LucasStrand/open-duck-mini-duckling/images/duckling-preview.png

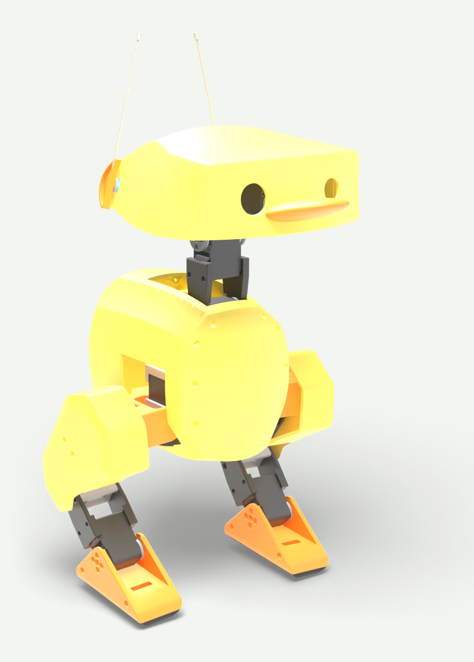
images/duckling-preview.png
