LucasStrand/open-duck-mini-duckling/stl/addons/duck_tail.stl

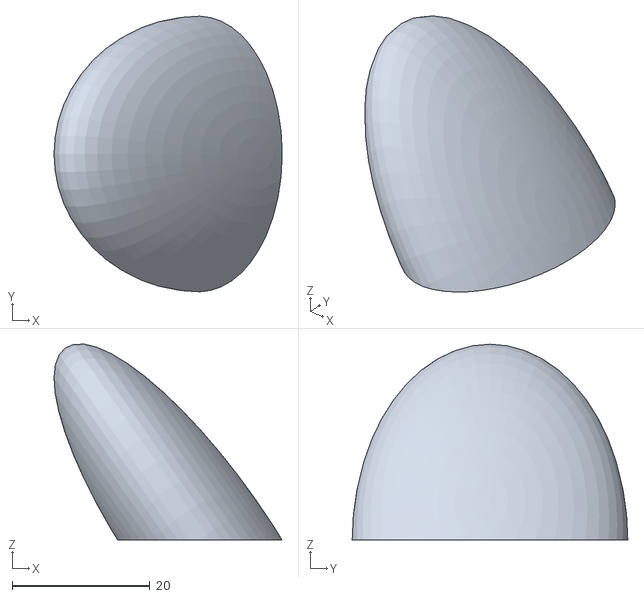
[picture p7: CAD file, 2026-10-24]
stl/addons/duck_tail.stl
33.1 x 40.0 x 28.4
