LucasStrand/open-duck-mini-duckling/stl/duckling/body_middle_top_duckling.stl

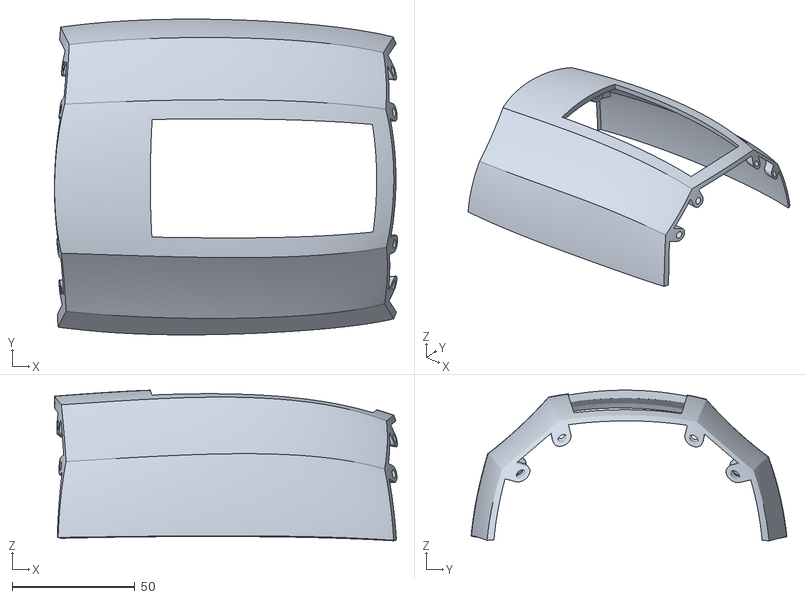
[picture p8: CAD file, 2026-10-24]
stl/duckling/body_middle_top_duckling.stl
139.8 x 128.7 x 61.4
