LucasStrand/open-duck-mini-duckling/stl/original/roll_motor_bottom.stl

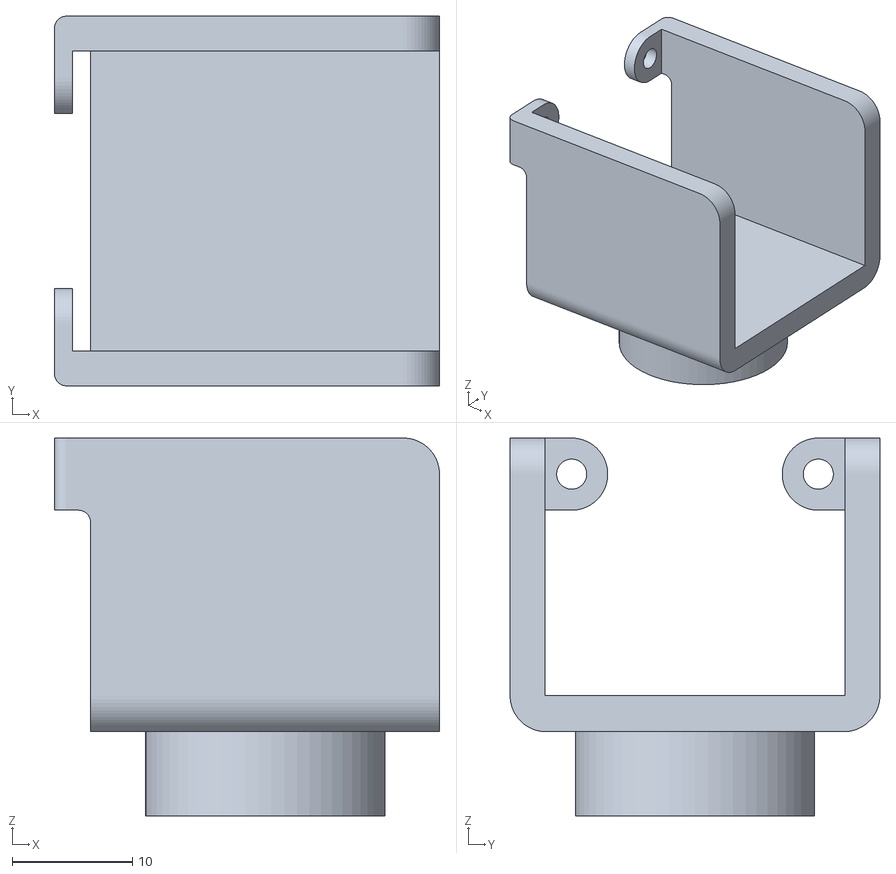
[picture p9: CAD file, 2026-10-24]
stl/original/roll_motor_bottom.stl
32.0 x 30.7 x 31.4
