LucasStrand/open-duck-mini-duckling/stl/pebble/body_front_pebble.stl

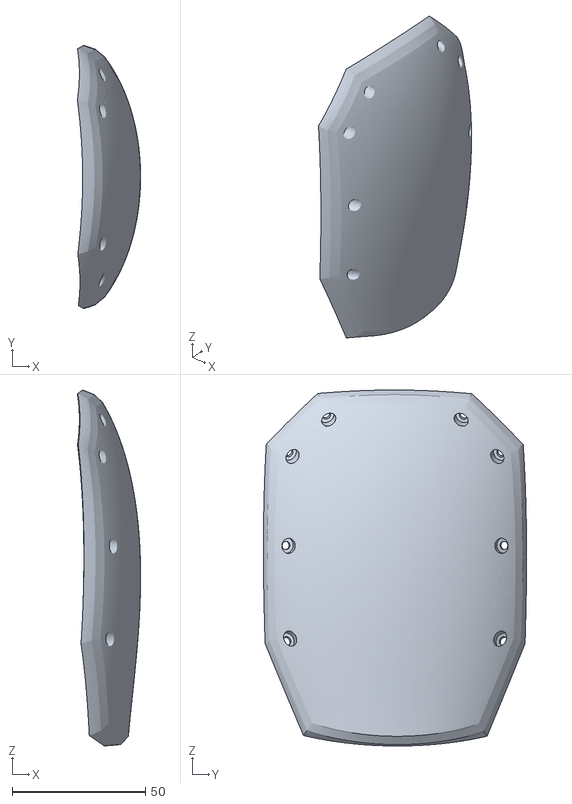
[picture p10: CAD file, 2026-10-24]
stl/pebble/body_front_pebble.stl
23.7 x 98.8 x 133.7
