LucasStrand/open-duck-mini-duckling/stl/visor/head_bot_sheet_visor.stl

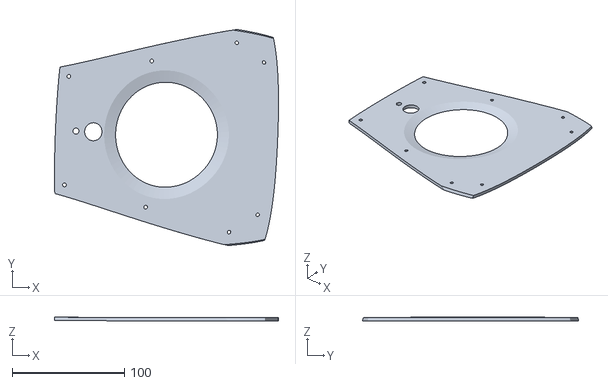
[picture p11: CAD file, 2026-10-24]
stl/visor/head_bot_sheet_visor.stl
199.8 x 192.8 x 3.16
