LucasStrand/open-duck-mini-duckling/stl/addons/duck_bill.stl

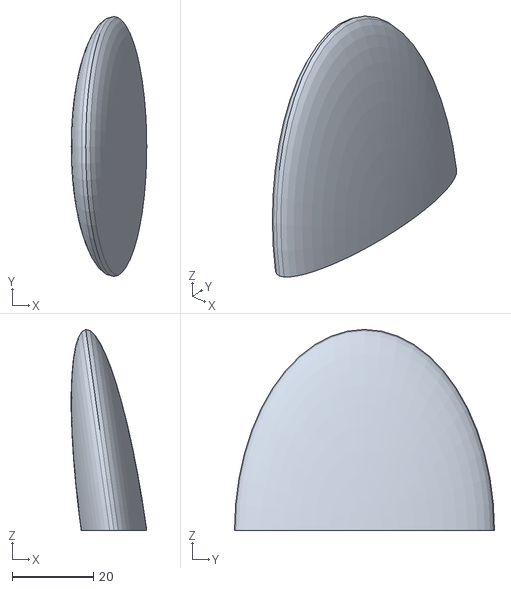
[picture p12: CAD file, 2026-10-24]
stl/addons/duck_bill.stl
18.6 x 64.0 x 49.5
