LucasStrand/open-duck-mini-duckling/stl/duckling/body_back_duckling.stl

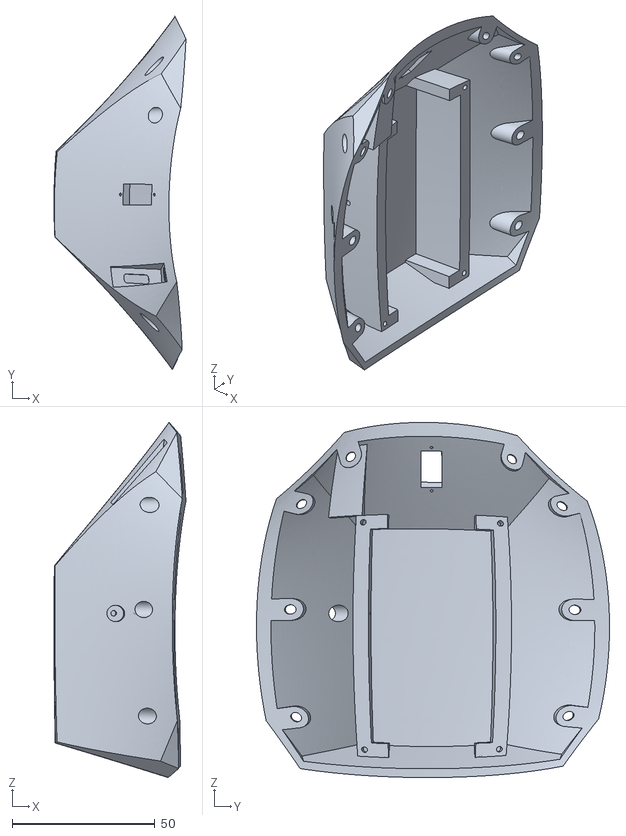
[picture p13: CAD file, 2026-10-24]
stl/duckling/body_back_duckling.stl
46.2 x 123.6 x 124.3
