LucasStrand/open-duck-mini-duckling/stl/original/right_eye.stl

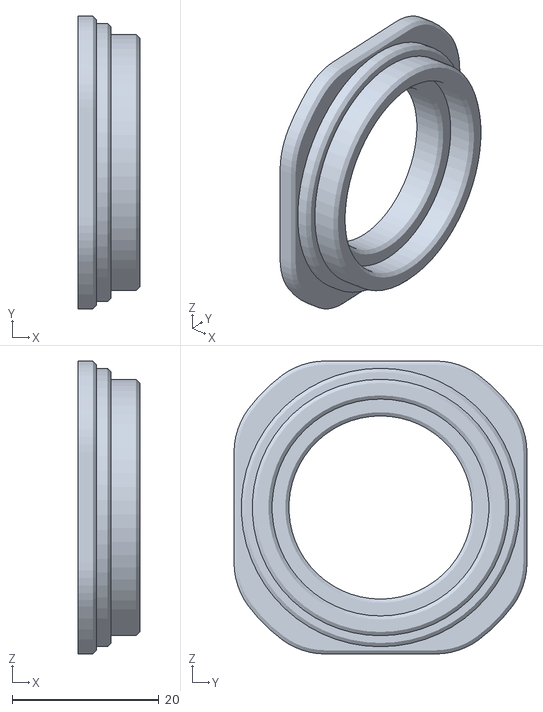
[picture p14: CAD file, 2026-10-24]
stl/original/right_eye.stl
8.40 x 40.0 x 40.0
