LucasStrand/open-duck-mini-duckling/stl/pebble/left_antenna_holder_pebble.stl

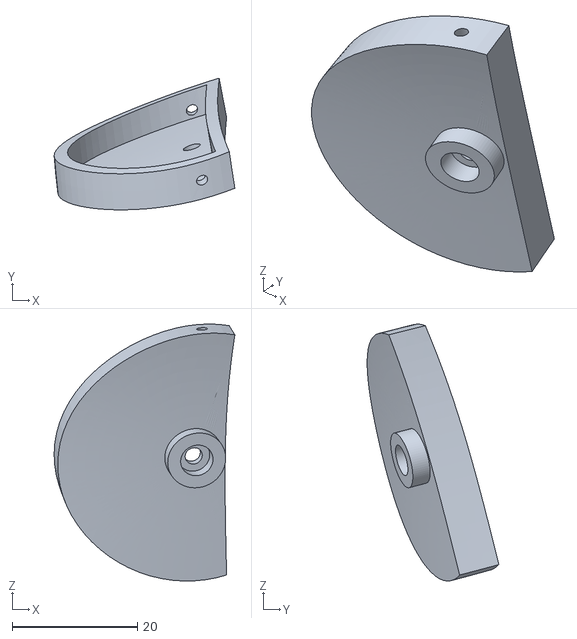
[picture p15: CAD file, 2026-10-24]
stl/pebble/left_antenna_holder_pebble.stl
28.9 x 21.0 x 41.1
