LucasStrand/open-duck-mini-duckling/stl/visor/right_cache_visor.stl

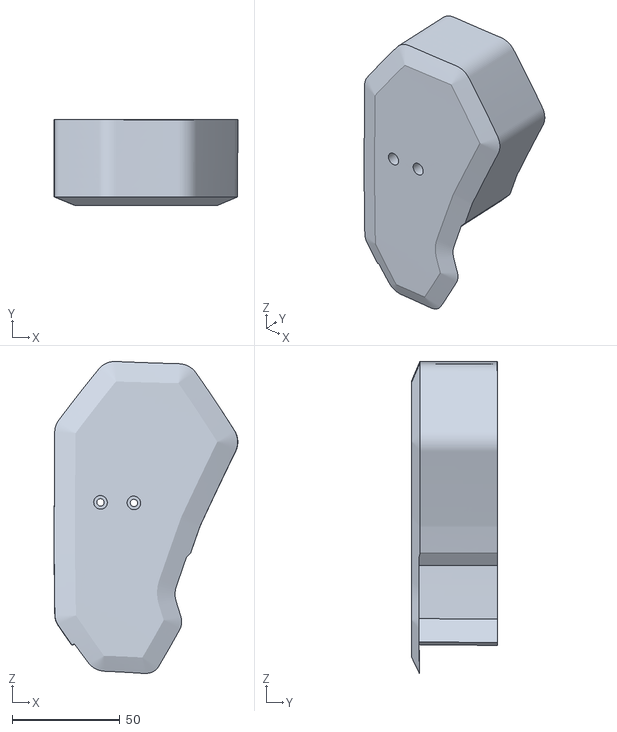
[picture p16: CAD file, 2026-10-24]
stl/visor/right_cache_visor.stl
85.4 x 40.2 x 145.0
