LucasStrand/open-duck-mini-duckling/stl/duckling/head_duckling.stl

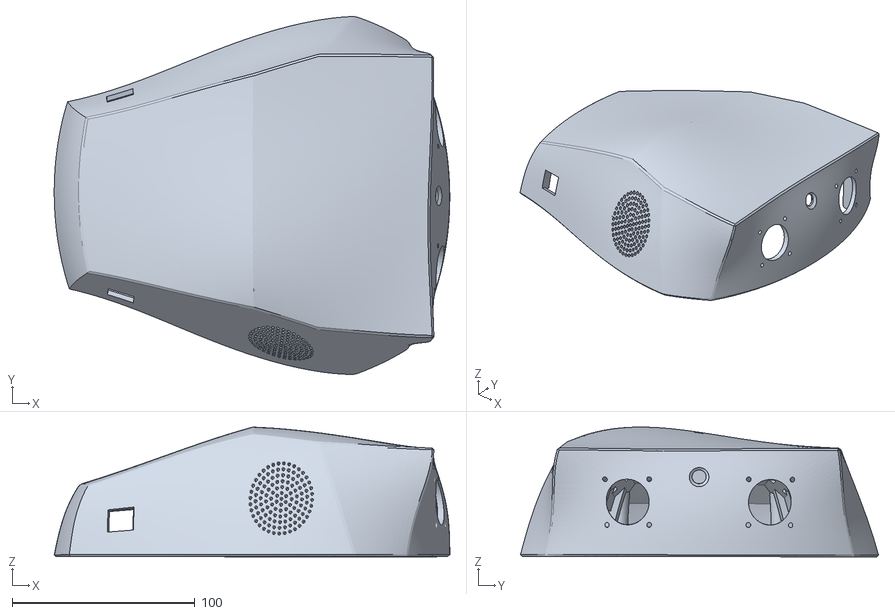
[picture p17: CAD file, 2026-10-24]
stl/duckling/head_duckling.stl
216.3 x 195.8 x 71.0
