LucasStrand/open-duck-mini-duckling/stl/original/left_roll_to_pitch.stl

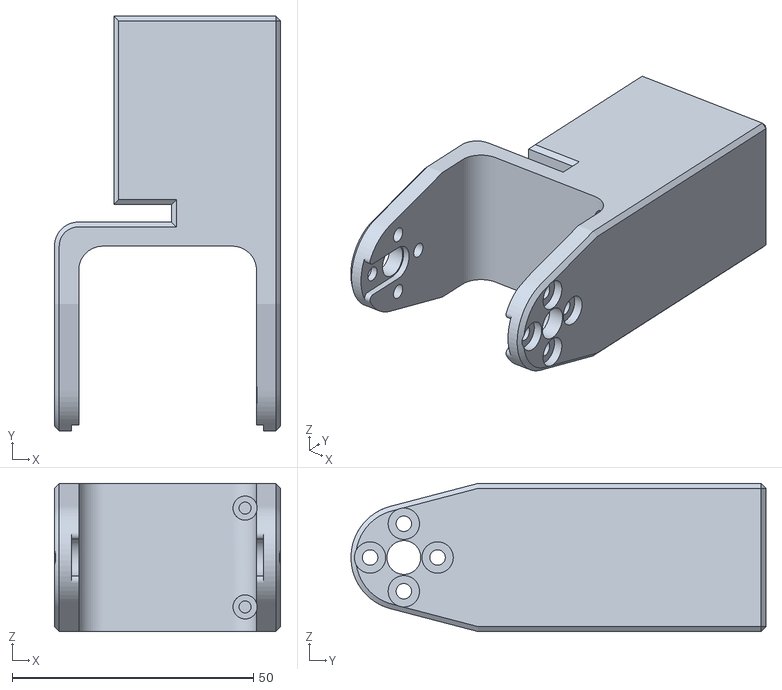
[picture p18: CAD file, 2026-10-24]
stl/original/left_roll_to_pitch.stl
46.9 x 86.1 x 30.7
