LucasStrand/open-duck-mini-duckling/stl/pebble/head_bot_sheet_pebble.stl

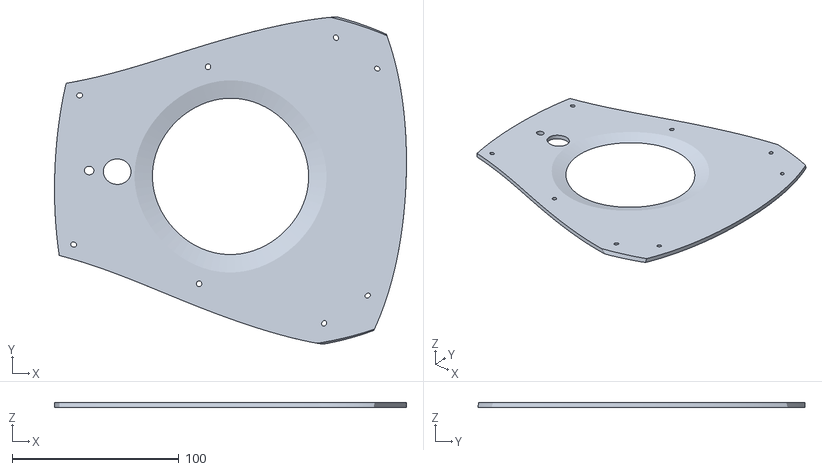
[picture p19: CAD file, 2026-10-24]
stl/pebble/head_bot_sheet_pebble.stl
210.8 x 196.1 x 3.02
