LucasStrand/open-duck-mini-duckling/stl/duckling/right_antenna_holder_duckling.stl

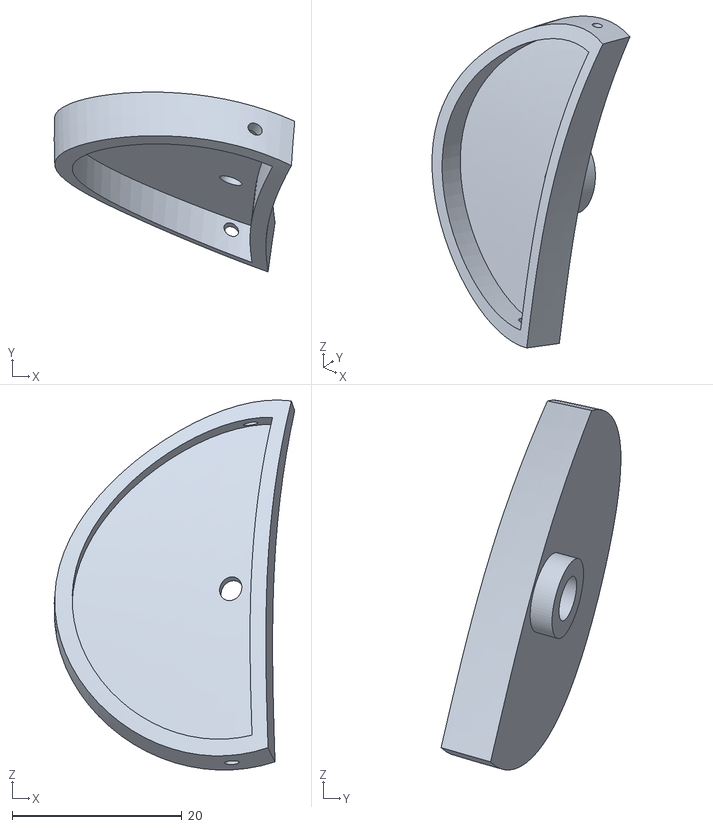
[picture p20: CAD file, 2026-10-24]
stl/duckling/right_antenna_holder_duckling.stl
28.3 x 21.2 x 43.6
