LucasStrand/open-duck-mini-duckling/stl/original/bulb.stl

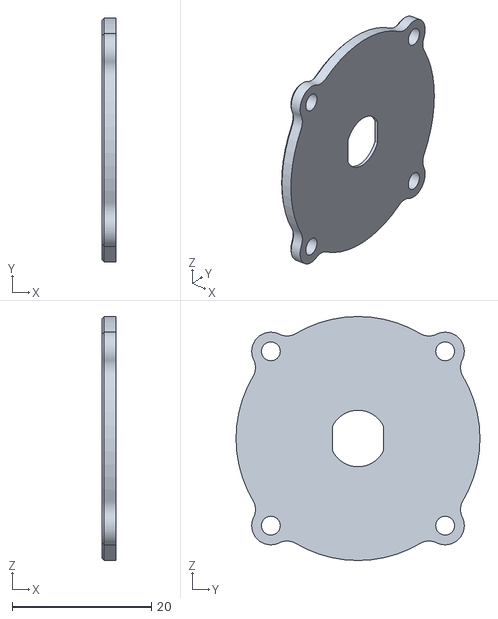
[picture p21: CAD file, 2026-10-24]
stl/original/bulb.stl
2.00 x 35.0 x 35.0
