LucasStrand/open-duck-mini-duckling/stl/pebble/body_middle_top_pebble.stl

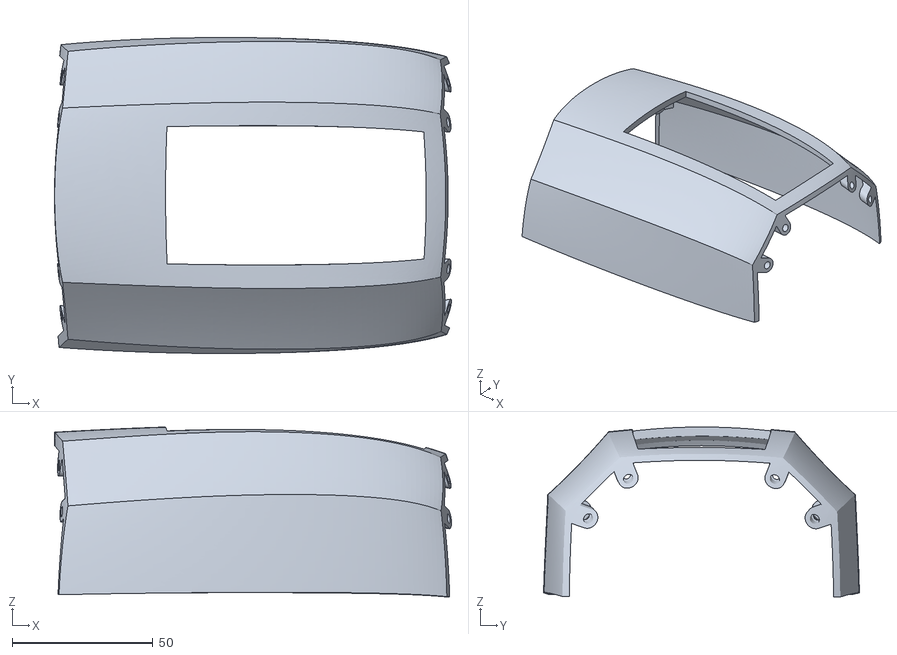
[picture p22: CAD file, 2026-10-24]
stl/pebble/body_middle_top_pebble.stl
141.0 x 112.2 x 60.4
