LucasStrand/open-duck-mini-duckling/stl/visor/body_back_visor.stl

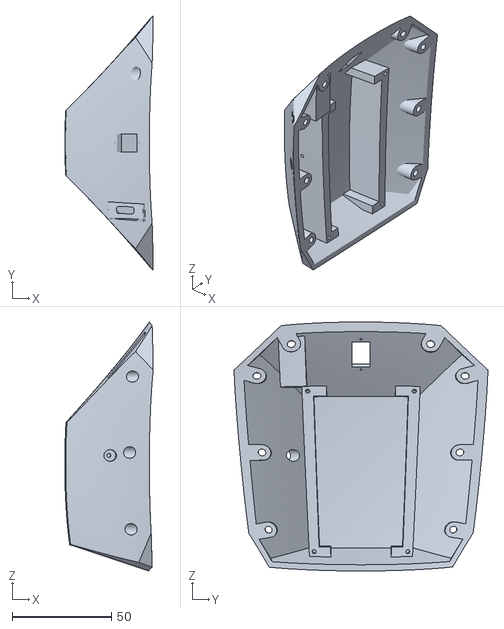
[picture p23: CAD file, 2026-10-24]
stl/visor/body_back_visor.stl
44.5 x 127.9 x 125.4
