LucasStrand/open-duck-mini-duckling/stl/duckling/battery_pack_lid_duckling.stl

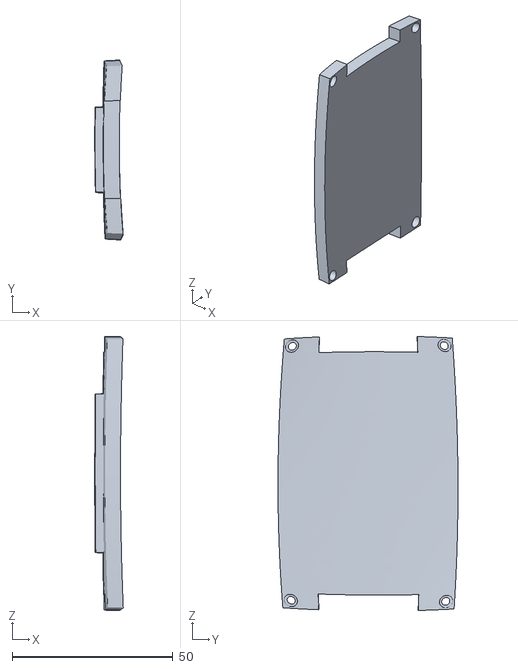
[picture p24: CAD file, 2026-10-24]
stl/duckling/battery_pack_lid_duckling.stl
8.90 x 56.0 x 85.3
