LucasStrand/open-duck-mini-duckling/stl/original/head_roll_mount.stl

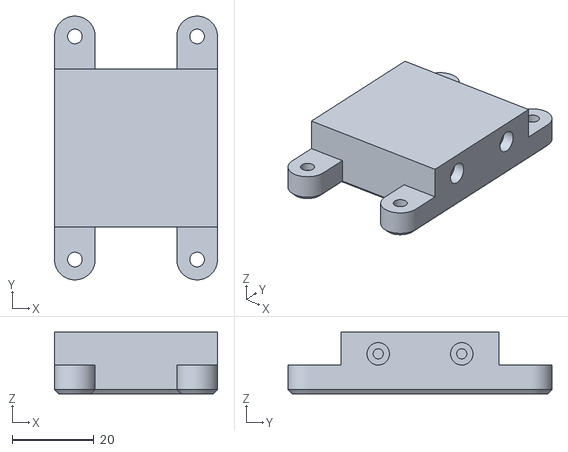
[picture p25: CAD file, 2026-10-24]
stl/original/head_roll_mount.stl
40.0 x 64.7 x 15.1
