LucasStrand/open-duck-mini-duckling/stl/pebble/body_back_pebble.stl

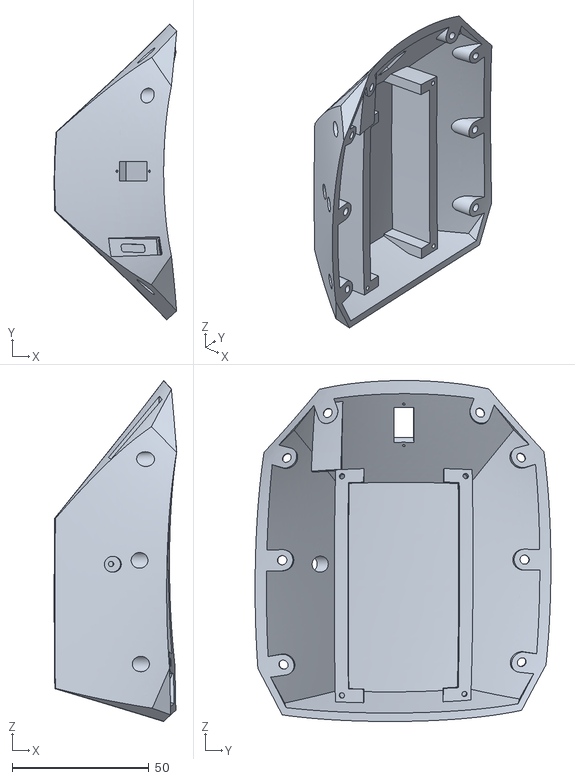
[picture p26: CAD file, 2026-10-24]
stl/pebble/body_back_pebble.stl
44.8 x 108.1 x 124.6
