LucasStrand/open-duck-mini-duckling/stl/visor/battery_pack_lid_visor.stl

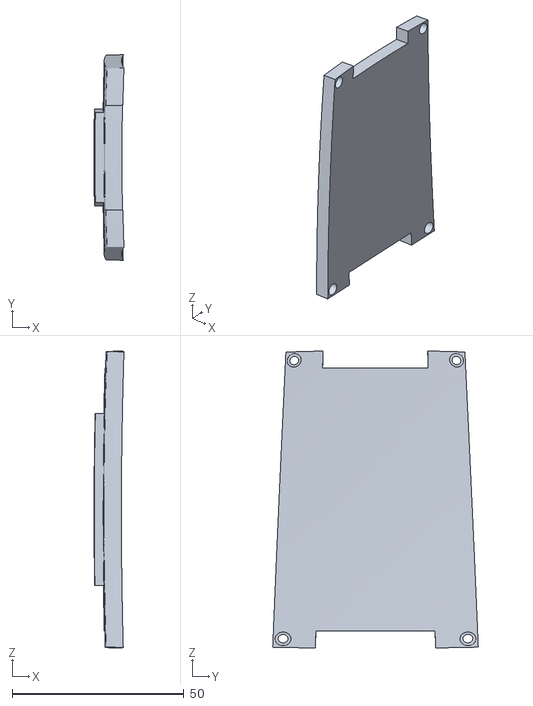
[picture p27: CAD file, 2026-10-24]
stl/visor/battery_pack_lid_visor.stl
8.72 x 59.8 x 86.4
