LucasStrand/open-duck-mini-duckling/stl/duckling/head_bot_sheet_duckling.stl

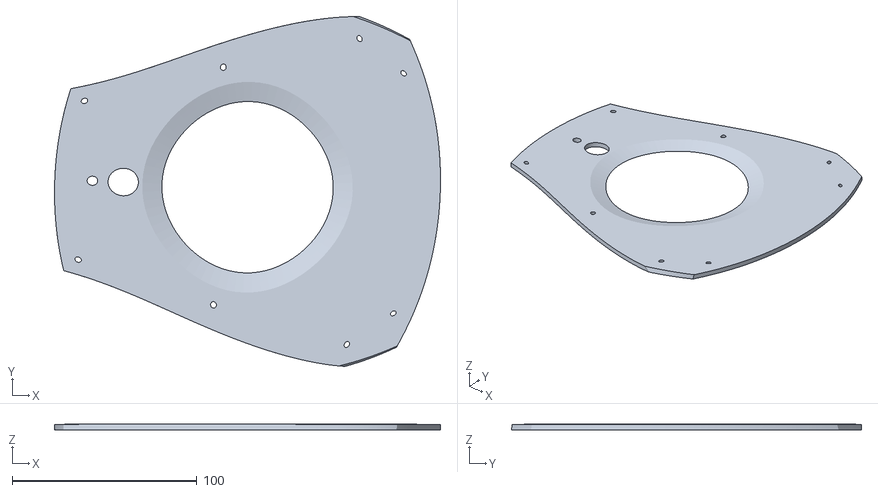
[picture p28: CAD file, 2026-10-24]
stl/duckling/head_bot_sheet_duckling.stl
209.1 x 189.5 x 3.10
