LucasStrand/open-duck-mini-duckling/stl/pebble/head_pebble.stl

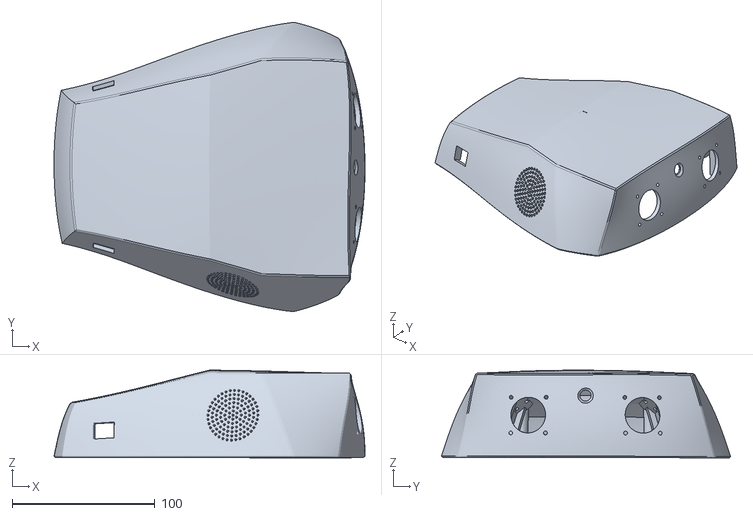
[picture p29: CAD file, 2026-10-24]
stl/pebble/head_pebble.stl
217.8 x 202.4 x 61.4
