LucasStrand/open-duck-mini-duckling/stl/visor/body_middle_top_visor.stl

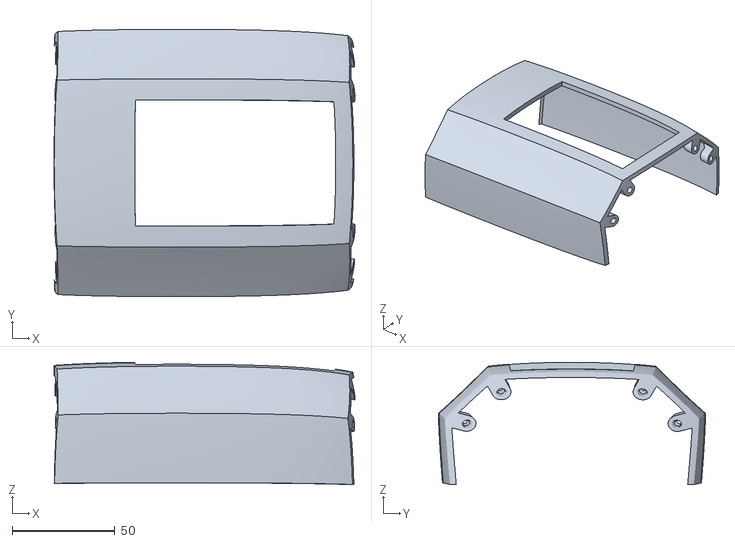
[picture p30: CAD file, 2026-10-24]
stl/visor/body_middle_top_visor.stl
146.3 x 130.0 x 59.5
