LucasStrand/open-duck-mini-duckling/stl/duckling/left_antenna_holder_duckling.stl

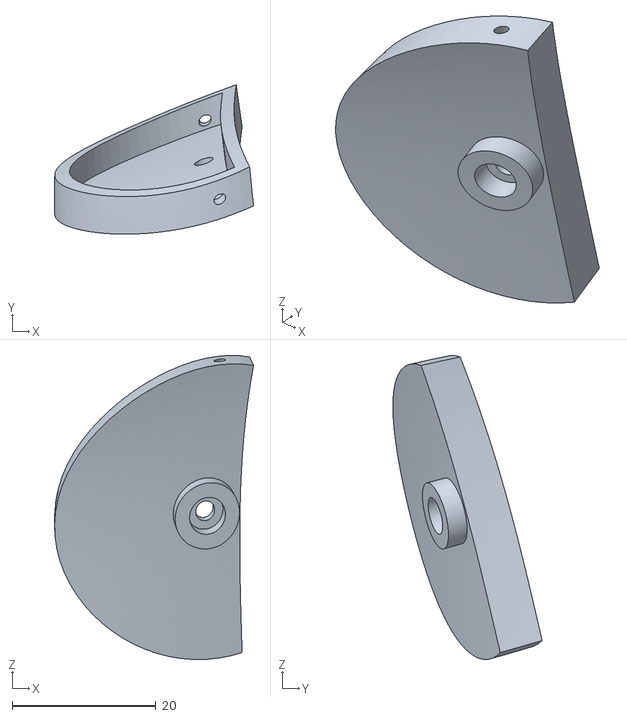
[picture p31: CAD file, 2026-10-24]
stl/duckling/left_antenna_holder_duckling.stl
27.7 x 20.8 x 42.3
