LucasStrand/open-duck-mini-duckling/stl/original/speaker_interface.stl

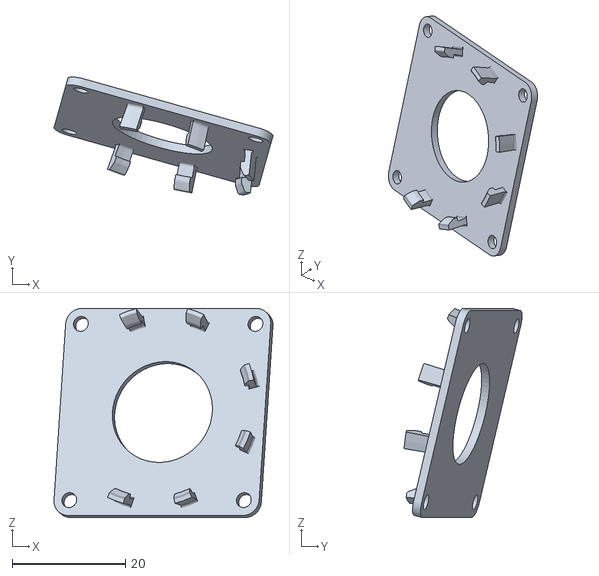
[picture p32: CAD file, 2026-10-24]
stl/original/speaker_interface.stl
38.6 x 20.8 x 36.9
