LucasStrand/open-duck-mini-duckling/stl/pebble/right_cache_pebble.stl

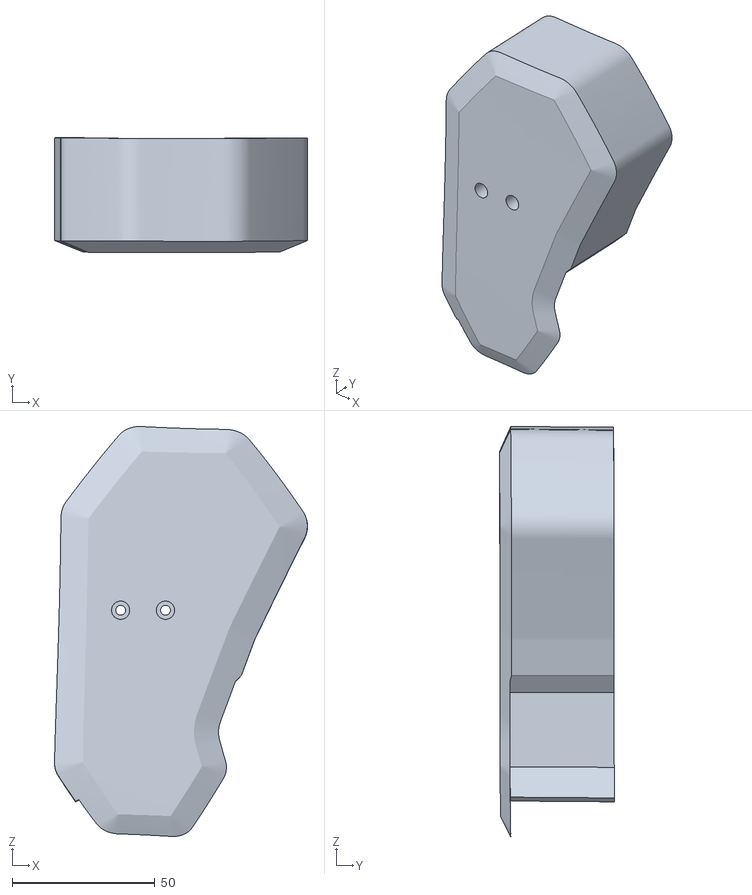
[picture p33: CAD file, 2026-10-24]
stl/pebble/right_cache_pebble.stl
88.6 x 40.3 x 143.6
