LucasStrand/open-duck-mini-duckling/stl/visor/left_antenna_holder_visor.stl

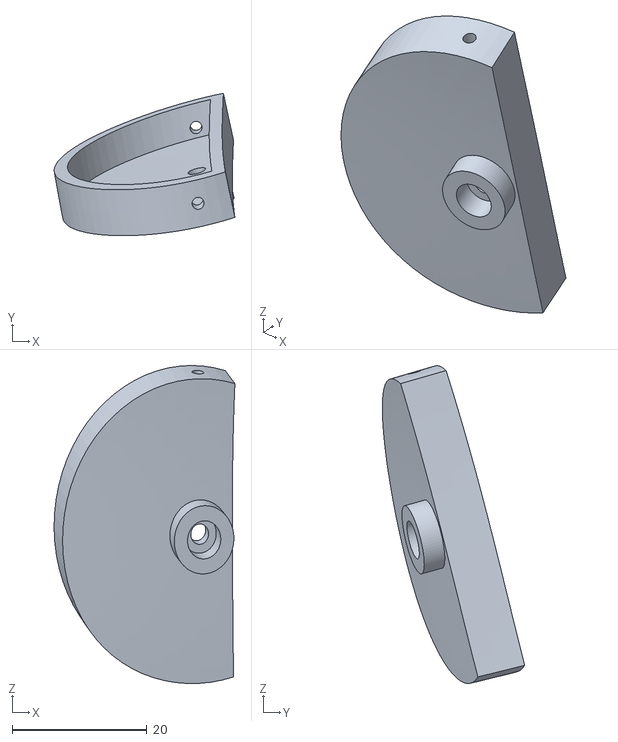
[picture p34: CAD file, 2026-10-24]
stl/visor/left_antenna_holder_visor.stl
26.8 x 21.1 x 47.2
