LucasStrand/open-duck-mini-duckling/stl/duckling/left_cache_duckling.stl

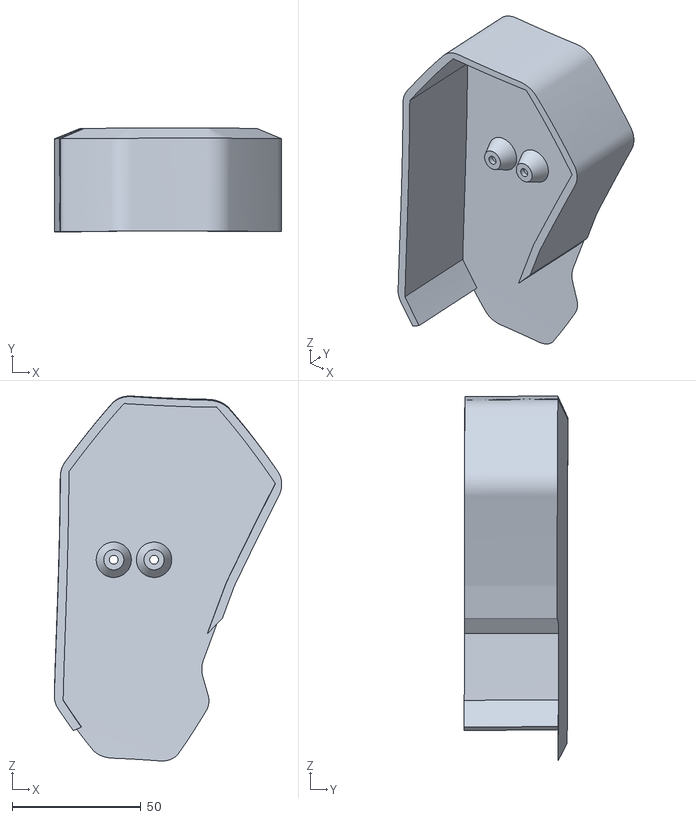
[picture p35: CAD file, 2026-10-24]
stl/duckling/left_cache_duckling.stl
88.2 x 40.3 x 141.5
