LucasStrand/open-duck-mini-duckling/stl/original/foot_side.stl

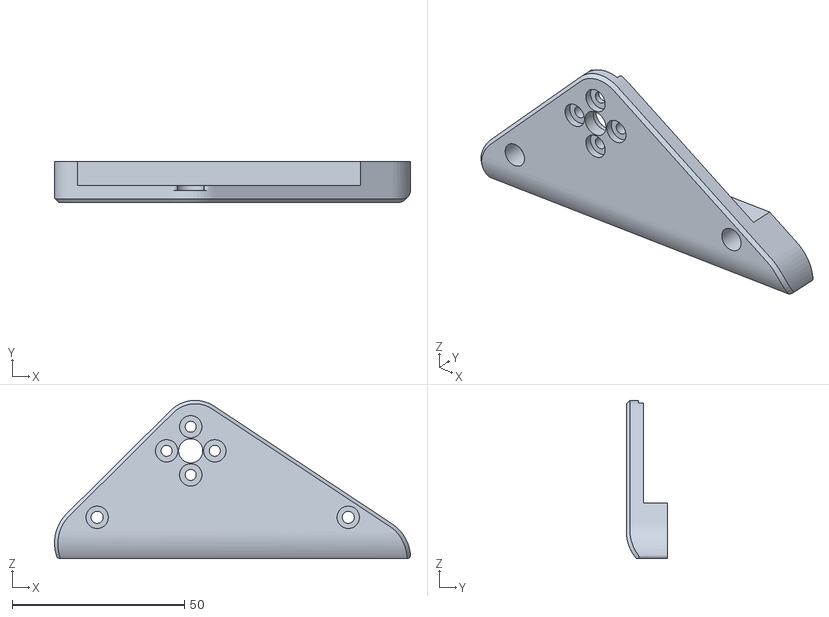
[picture p36: CAD file, 2026-10-24]
stl/original/foot_side.stl
103.5 x 12.0 x 46.0
