LucasStrand/open-duck-mini-duckling/stl/pebble/body_middle_bottom_pebble.stl

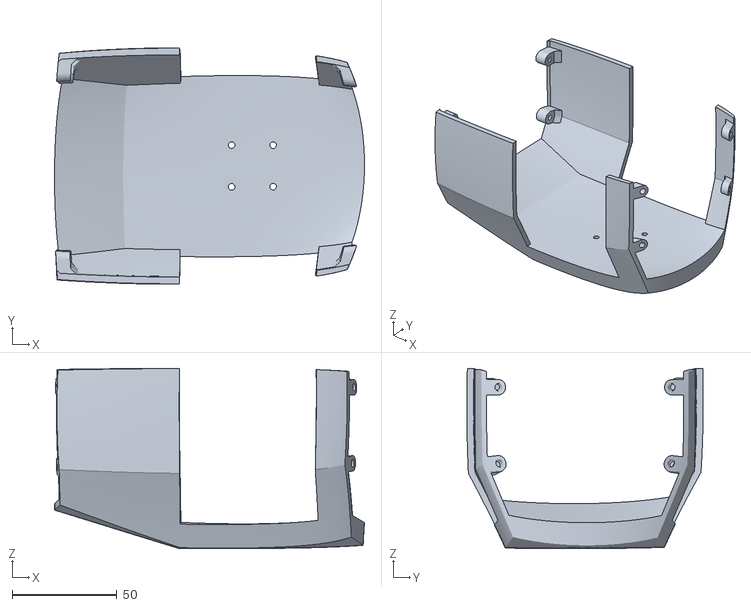
[picture p37: CAD file, 2026-10-24]
stl/pebble/body_middle_bottom_pebble.stl
147.8 x 112.7 x 86.0
