LucasStrand/open-duck-mini-duckling/stl/visor/body_middle_bottom_visor.stl

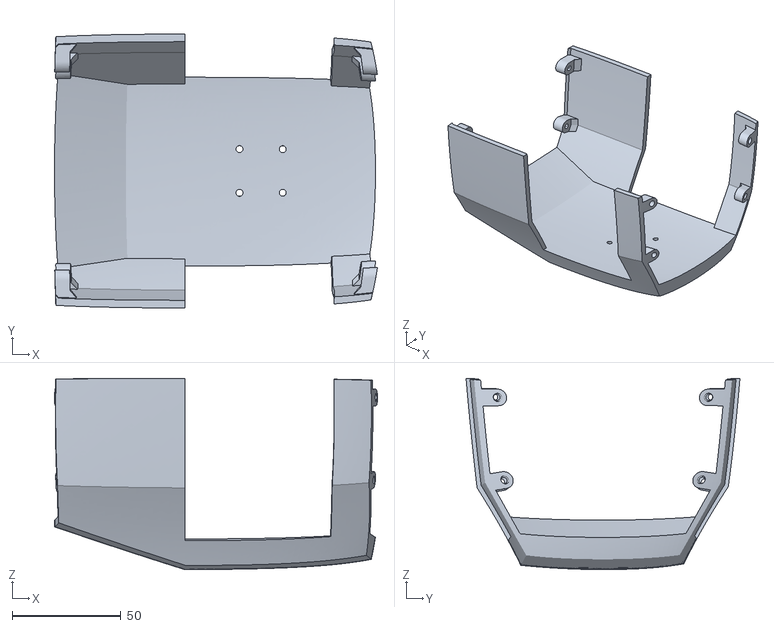
[picture p38: CAD file, 2026-10-24]
stl/visor/body_middle_bottom_visor.stl
148.5 x 125.9 x 87.9
