LucasStrand/open-duck-mini-duckling/stl/original/foot_bottom_tpu.stl

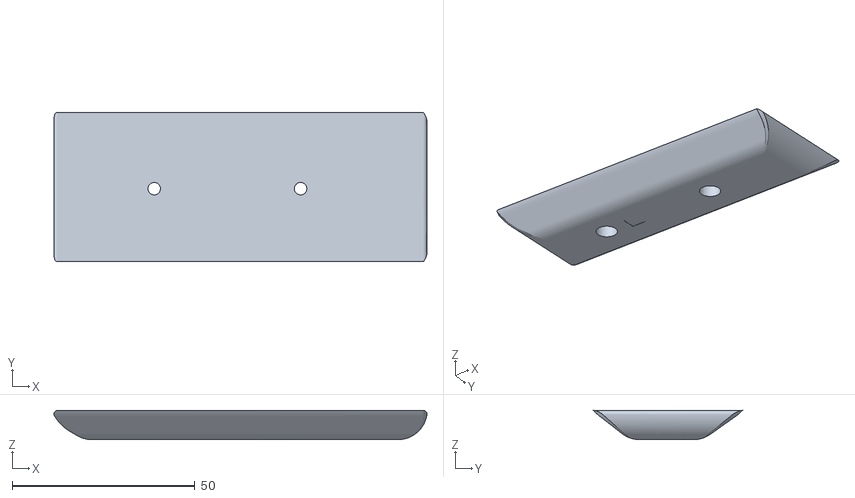
[picture p39: CAD file, 2026-10-24]
stl/original/foot_bottom_tpu.stl
101.9 x 40.7 x 8.00
