LucasStrand/open-duck-mini-duckling/stl/visor/head_visor.stl

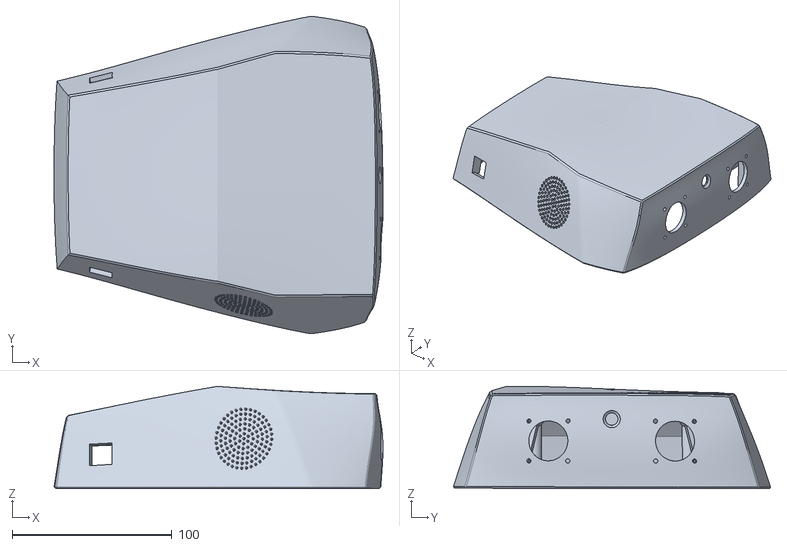
[picture p40: CAD file, 2026-10-24]
stl/visor/head_visor.stl
206.0 x 198.6 x 64.1
