LucasStrand/open-duck-mini-duckling/stl/duckling/body_front_duckling.stl

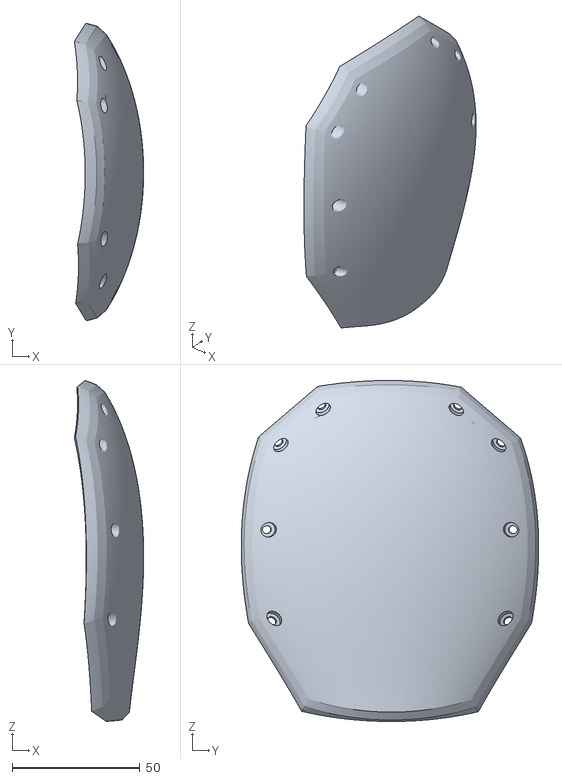
[picture p41: CAD file, 2026-10-24]
stl/duckling/body_front_duckling.stl
27.1 x 116.3 x 133.3
