LucasStrand/open-duck-mini-duckling/stl/original/roll_motor_top.stl

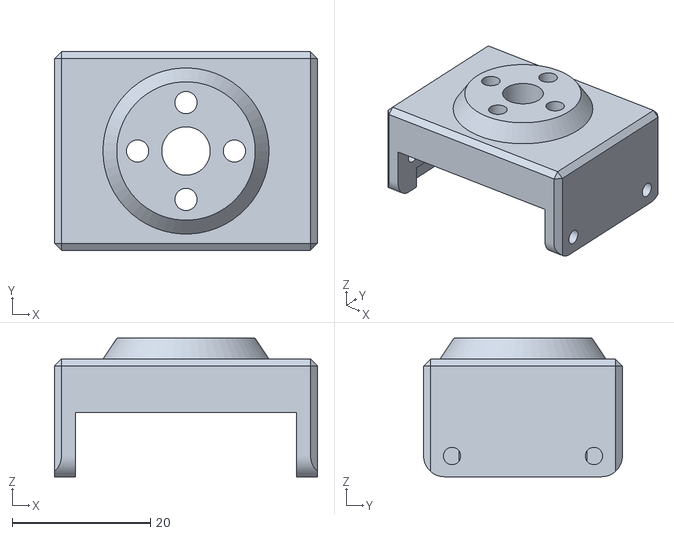
[picture p42: CAD file, 2026-10-24]
stl/original/roll_motor_top.stl
38.0 x 28.7 x 20.0
