LucasStrand/open-duck-mini-duckling/stl/visor/body_front_visor.stl

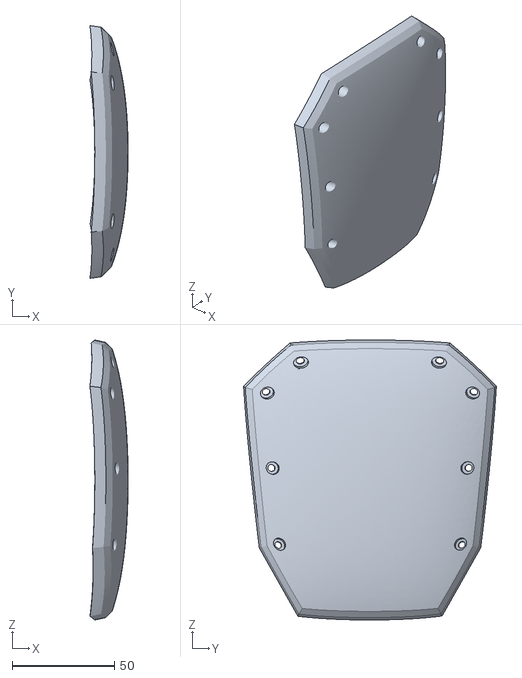
[picture p43: CAD file, 2026-10-24]
stl/visor/body_front_visor.stl
18.7 x 123.7 x 137.0
