LucasStrand/open-duck-mini-duckling/stl/duckling/body_middle_bottom_duckling.stl

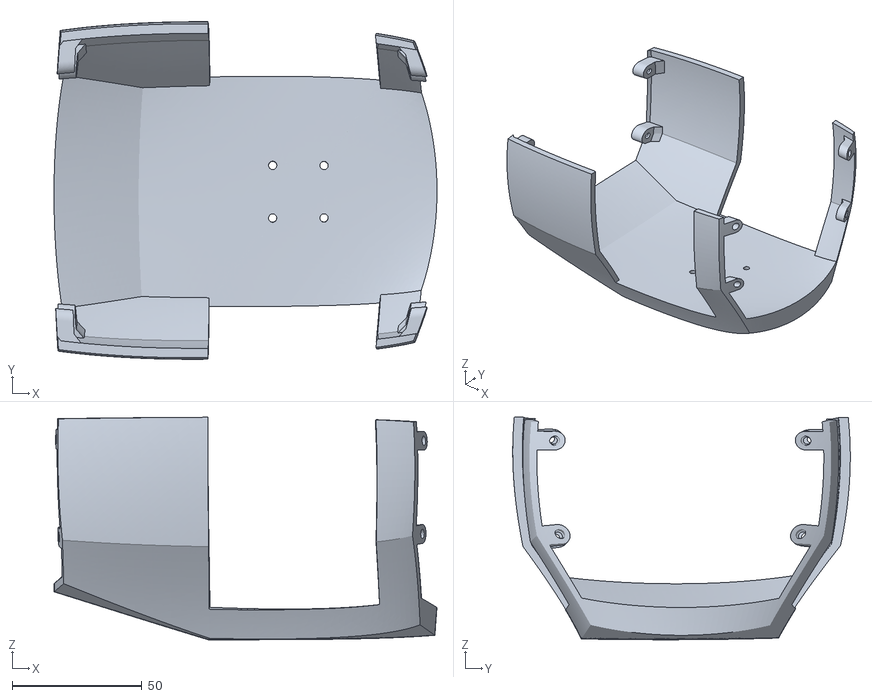
[picture p44: CAD file, 2026-10-24]
stl/duckling/body_middle_bottom_duckling.stl
147.6 x 130.1 x 85.8
