LucasStrand/open-duck-mini-duckling/stl/original/foot_bottom_pla.stl

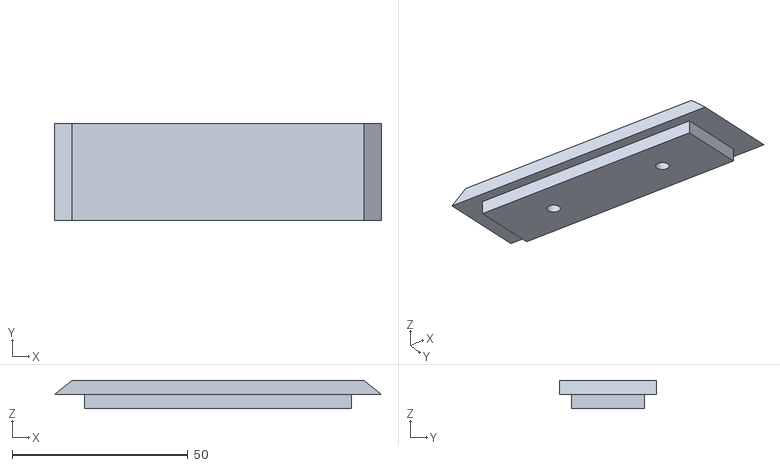
[picture p45: CAD file, 2026-10-24]
stl/original/foot_bottom_pla.stl
93.0 x 27.7 x 8.00
