LucasStrand/open-duck-mini-duckling/stl/pebble/battery_pack_lid_pebble.stl

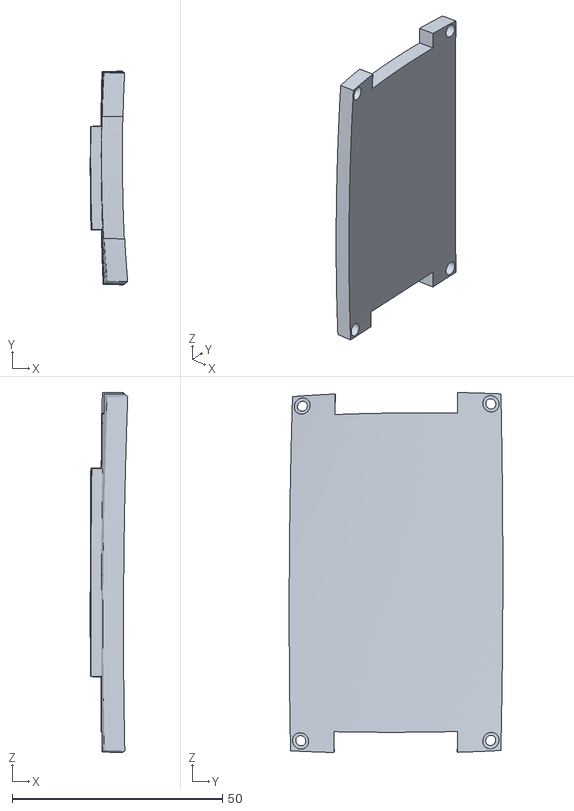
[picture p46: CAD file, 2026-10-24]
stl/pebble/battery_pack_lid_pebble.stl
8.93 x 50.9 x 85.7
