LucasStrand/open-duck-mini-duckling/stl/visor/right_antenna_holder_visor.stl

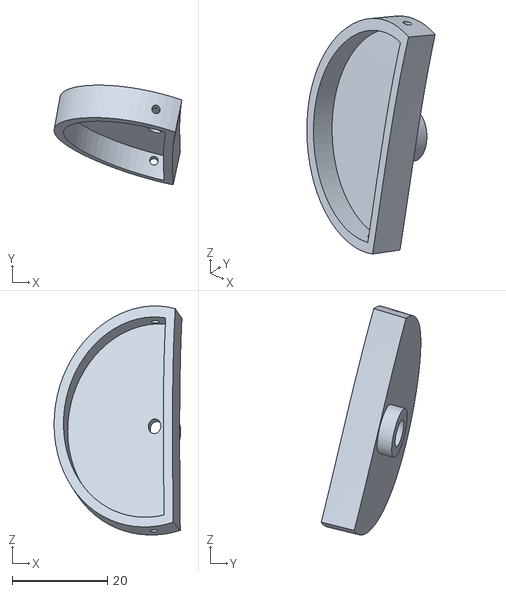
[picture p47: CAD file, 2026-10-24]
stl/visor/right_antenna_holder_visor.stl
26.9 x 21.0 x 48.2
