LucasStrand/open-duck-mini-duckling/stl/original/knee_to_ankle_left_sheet.stl

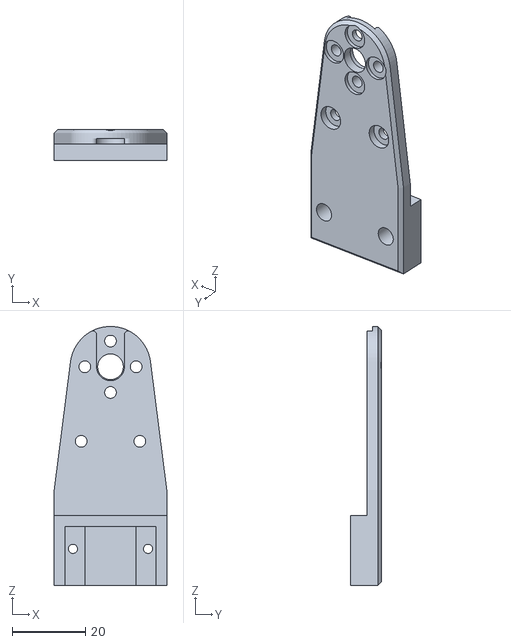
[picture p48: CAD file, 2026-10-24]
stl/original/knee_to_ankle_left_sheet.stl
30.7 x 8.45 x 70.6
