LucasStrand/open-duck-mini-duckling/stl/original/foot_top.stl

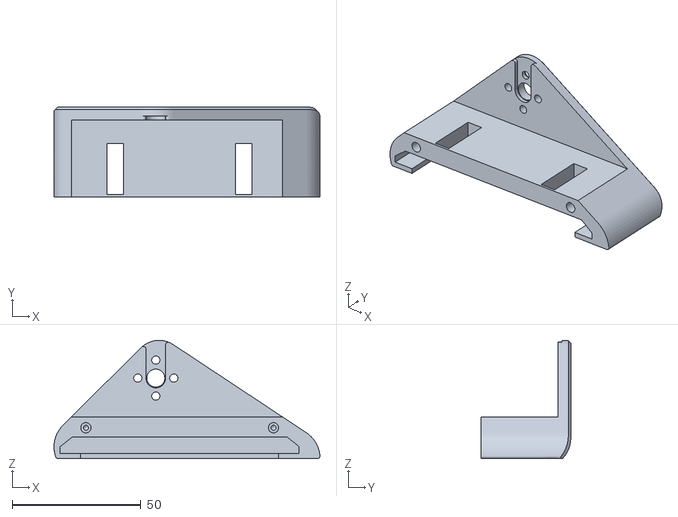
[picture p49: CAD file, 2026-10-24]
stl/original/foot_top.stl
103.5 x 34.9 x 46.0
