LucasStrand/open-duck-mini-duckling/stl/original/left_eye.stl

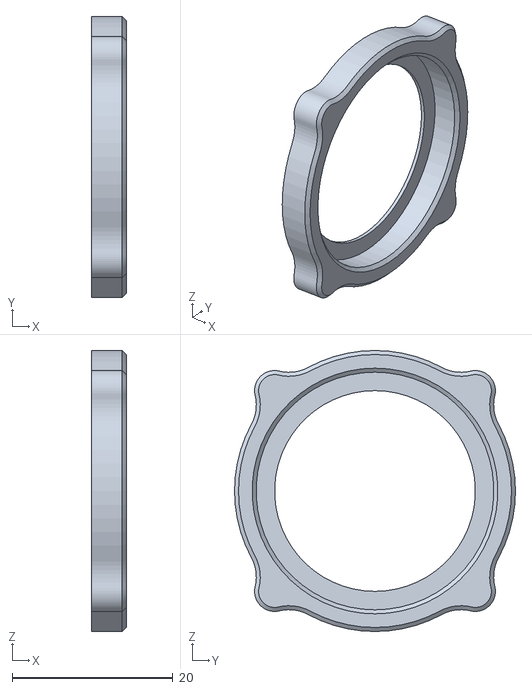
[picture p50: CAD file, 2026-10-24]
stl/original/left_eye.stl
4.30 x 35.0 x 35.0
