LucasStrand/open-duck-mini-duckling/stl/original/flash_reflector_interface.stl

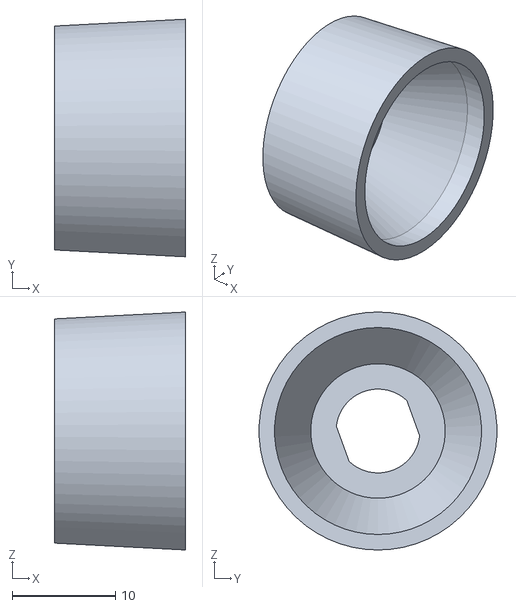
[picture p51: CAD file, 2026-10-24]
stl/original/flash_reflector_interface.stl
12.7 x 23.0 x 23.0
