LucasStrand/open-duck-mini-duckling/stl/original/head_yaw_to_roll.stl

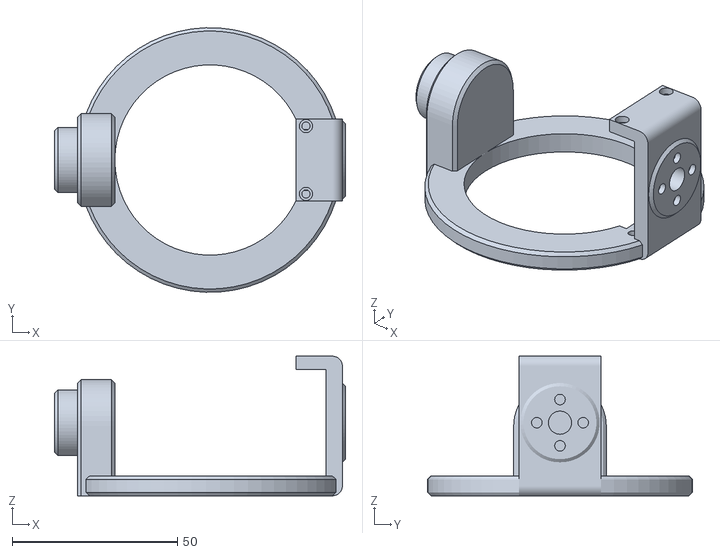
[picture p52: CAD file, 2026-10-24]
stl/original/head_yaw_to_roll.stl
88.0 x 80.0 x 42.2
