LucasStrand/open-duck-mini-duckling/stl/original/leg_spacer.stl

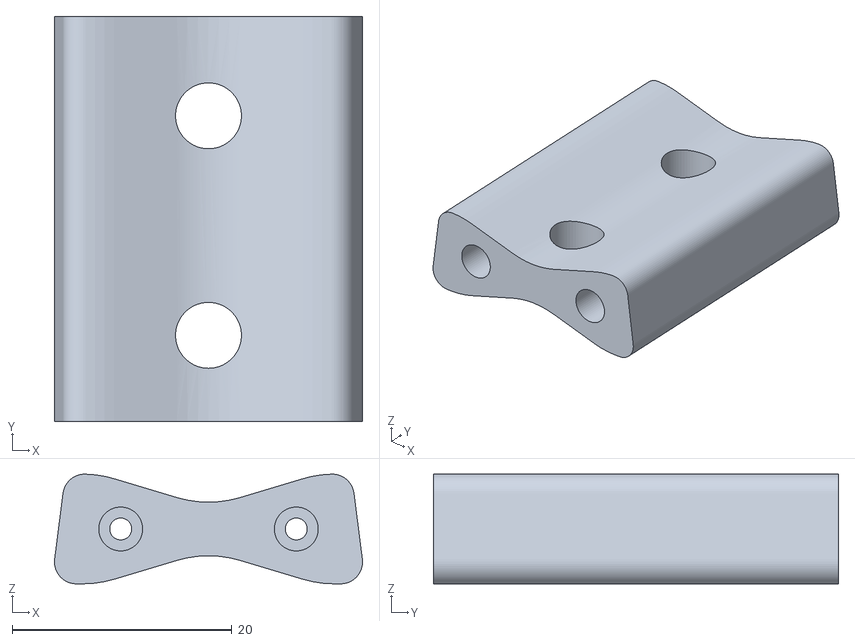
[picture p53: CAD file, 2026-10-24]
stl/original/leg_spacer.stl
28.1 x 36.9 x 10.00
