LucasStrand/open-duck-mini-duckling/stl/original/trunk_top.stl

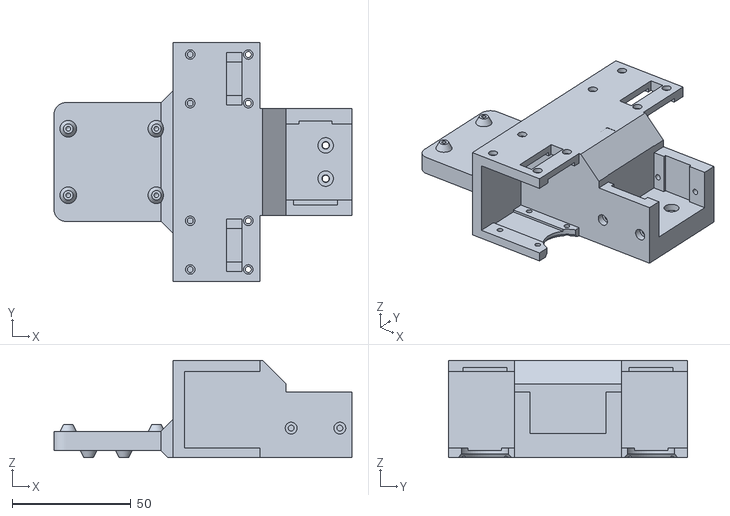
[picture p54: CAD file, 2026-10-24]
stl/original/trunk_top.stl
125.5 x 100.7 x 41.0
