LucasStrand/open-duck-mini-duckling/stl/original/speaker_stand.stl

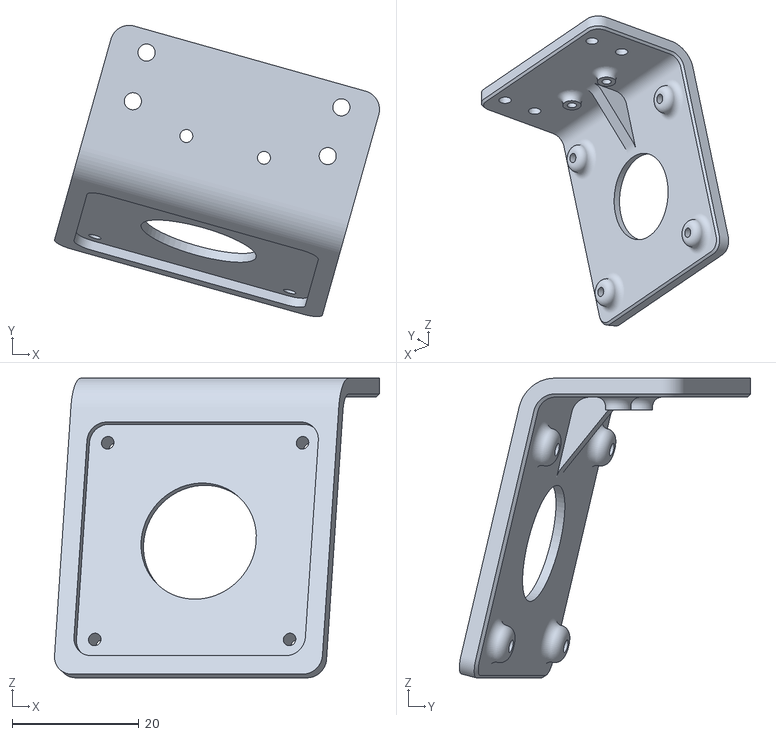
[picture p55: CAD file, 2026-10-24]
stl/original/speaker_stand.stl
51.4 x 46.0 x 47.4
