LucasStrand/open-duck-mini-duckling/stl/original/knee_to_ankle_right_sheet.stl

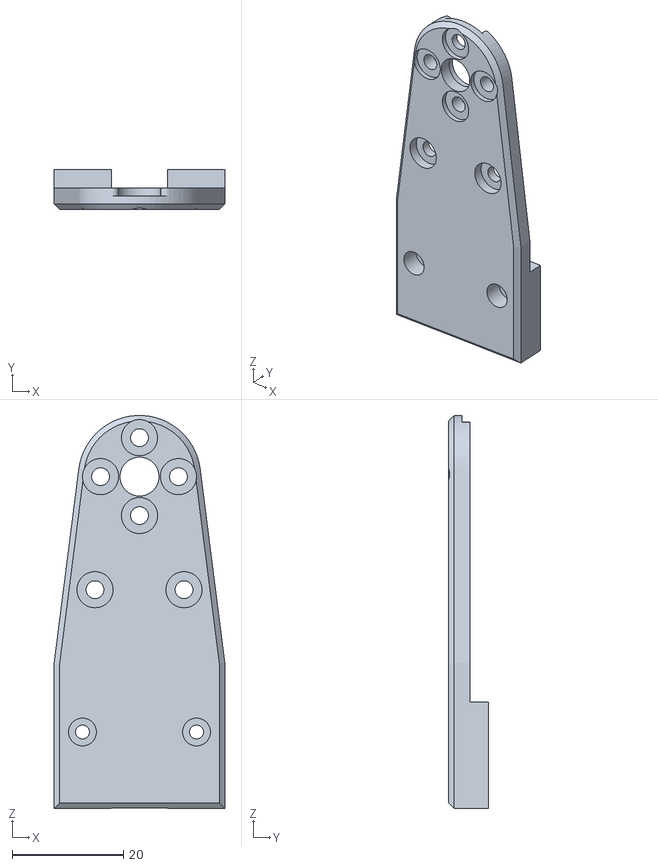
[picture p56: CAD file, 2026-10-24]
stl/original/knee_to_ankle_right_sheet.stl
30.7 x 7.20 x 70.6
