LucasStrand/open-duck-mini-duckling/stl/original/head_pitch_to_yaw.stl

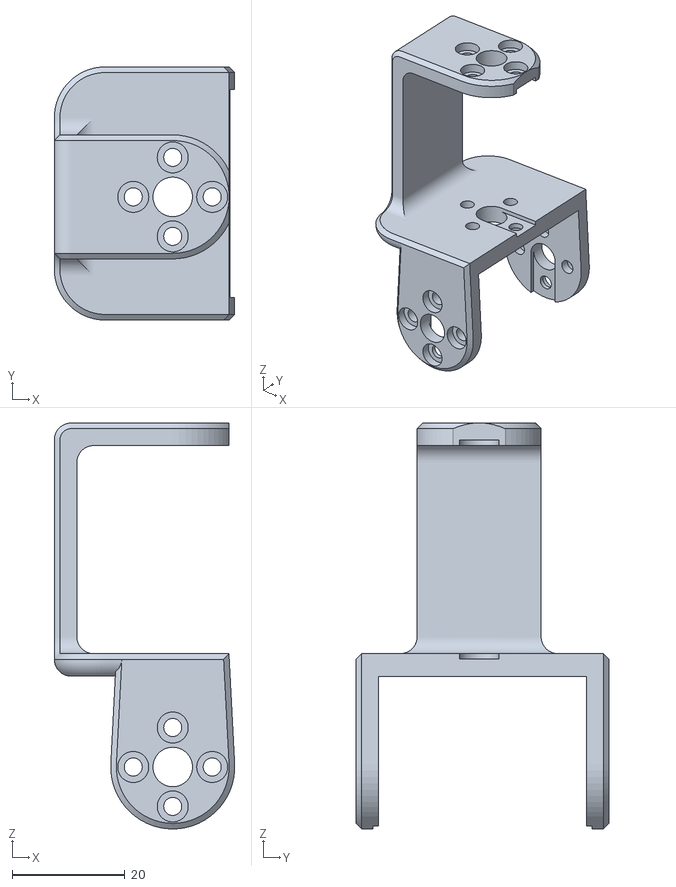
[picture p57: CAD file, 2026-10-24]
stl/original/head_pitch_to_yaw.stl
32.0 x 44.9 x 72.0
