LucasStrand/open-duck-mini-duckling/stl/original/neck_left_sheet.stl

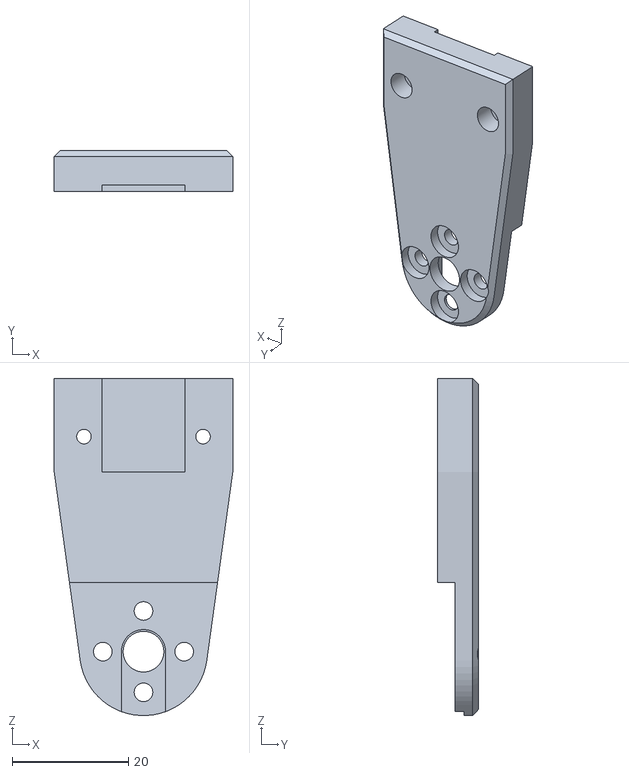
[picture p58: CAD file, 2026-10-24]
stl/original/neck_left_sheet.stl
30.7 x 7.05 x 58.0
