LucasStrand/open-duck-mini-duckling/stl/original/neck_right_sheet.stl

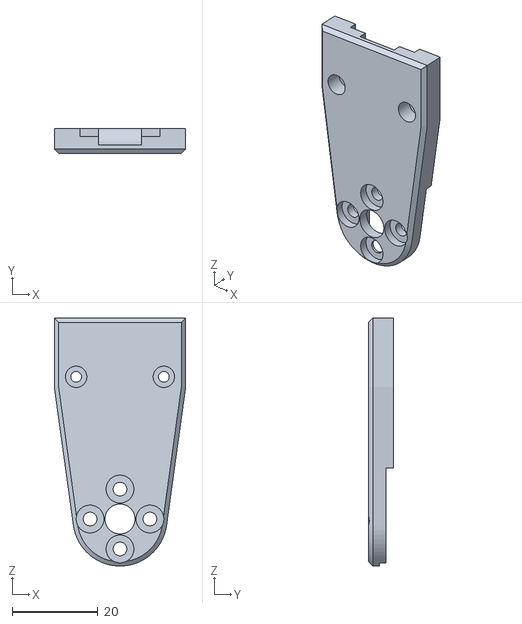
[picture p59: CAD file, 2026-10-24]
stl/original/neck_right_sheet.stl
30.7 x 5.85 x 58.0
