LucasStrand/open-duck-mini-duckling/stl/original/flash_light_module.stl

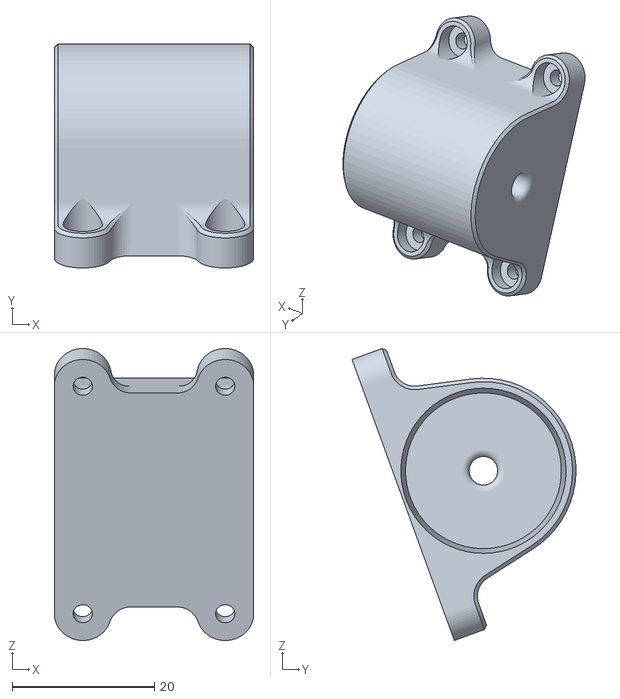
[picture p60: CAD file, 2026-10-24]
stl/original/flash_light_module.stl
28.0 x 31.5 x 41.0
