LucasStrand/open-duck-mini-duckling/stl/original/trunk_bottom.stl

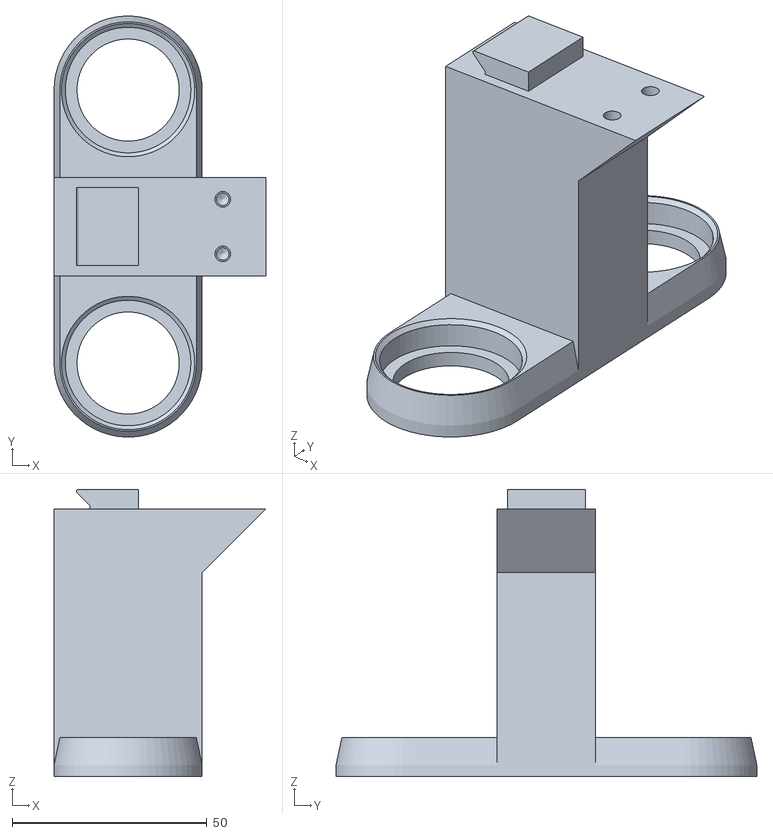
[picture p61: CAD file, 2026-10-24]
stl/original/trunk_bottom.stl
54.4 x 108.0 x 73.7
