LucasStrand/open-duck-mini-duckling/(list of files, cad)

Other CAD files:
stl/visor/left_cache_visor.stl
stl/original/right_roll_to_pitch.stl
stl/duckling/right_cache_duckling.stl
stl/pebble/right_antenna_holder_pebble.stl
stl/pebble/left_cache_pebble.stl
blender/open-duck-mini.blend
