LucasStrand/open-duck-mini-duckling/PRINT-LIST-visor.txt

OPEN DUCK MINI v2 - "VISOR" PRINT LIST
======================================

36 files, 51 pieces in total. Everything is in millimetres.
The official parts with the outer shells swapped for the Visor design: an angular head that rises at the back, a brow, a V-shaped chest.
See images/visor-views.png for what the finished duck looks like.

SETTINGS
  - PLA at 15% infill for everything, except foot_bottom_tpu: TPU at 40% infill.
  - New shells: 3 walls/perimeters, supports where the slicer asks for them.
    The files come in the official orientation; the curved ones may print better
    turned onto a different face. Let the slicer's lay-flat/auto-orient decide.
  - Biggest part: head_visor.stl (206 x 199 x 64 mm). Needs a bed of at least 220 x 200 mm.

FIRST
  The new shells haven't been test-printed. Print the head and the head bottom plate
  first and check the head sits flush and the screw holes line up before printing
  the body. Holes near strongly curved areas may need drilling out.

PARTS
  file                                        qty  material  colour               size mm     notes
  stl/visor/head_visor.stl                      1  PLA 15%  graphite (#2e3337)   206x199x64  NEW SHAPE. Print this first and test-fit it.
  stl/visor/head_bot_sheet_visor.stl            1  PLA 15%  dark grey            200x193x3   New outline to match the head.
  stl/visor/left_antenna_holder_visor.stl       1  PLA 15%  orange (#ff7a1a)     47x27x21    Ear cap, new shape.
  stl/visor/right_antenna_holder_visor.stl      1  PLA 15%  orange (#ff7a1a)     48x27x21    Ear cap, new shape.
  stl/visor/body_front_visor.stl                1  PLA 15%  graphite (#2e3337)   137x124x19  NEW SHAPE. No flat face: needs supports or another orientation.
  stl/visor/body_back_visor.stl                 1  PLA 15%  graphite (#2e3337)   128x125x45  NEW SHAPE. No flat face: needs supports or another orientation.
  stl/visor/body_middle_top_visor.stl           1  PLA 15%  graphite (#2e3337)   146x130x59  NEW SHAPE. No flat face: needs supports or another orientation.
  stl/visor/body_middle_bottom_visor.stl        1  PLA 15%  graphite (#2e3337)   148x126x88  NEW SHAPE.
  stl/visor/battery_pack_lid_visor.stl          1  PLA 15%  graphite (#2e3337)   86x60x9     NEW SHAPE. No flat face: needs supports or another orientation.
  stl/visor/left_cache_visor.stl                1  PLA 15%  dark grey (#3d444a)  145x85x40   Thigh cover, NEW SHAPE. No flat face: needs supports or another orientation.
  stl/visor/right_cache_visor.stl               1  PLA 15%  dark grey (#3d444a)  145x85x40   Thigh cover, NEW SHAPE. No flat face: needs supports or another orientation.
  stl/original/foot_top.stl                     2  PLA 15%  orange (#ff7a1a)     103x46x35
  stl/original/foot_side.stl                    2  PLA 15%  orange (#ff7a1a)     103x46x12
  stl/original/foot_bottom_pla.stl              2  PLA 15%  dark grey            93x28x8
  stl/original/foot_bottom_tpu.stl              2  TPU 40%  black TPU            102x41x8    The grippy sole: must be TPU.
  stl/original/knee_to_ankle_left_sheet.stl     4  PLA 15%  dark grey            71x31x8
  stl/original/knee_to_ankle_right_sheet.stl    4  PLA 15%  dark grey            71x31x7
  stl/original/leg_spacer.stl                   4  PLA 15%  dark grey            37x28x10
  stl/original/left_roll_to_pitch.stl           1  PLA 15%  orange (#ff7a1a)     86x47x31    Hip.
  stl/original/right_roll_to_pitch.stl          1  PLA 15%  orange (#ff7a1a)     86x47x31    Hip.
  stl/original/roll_motor_bottom.stl            2  PLA 15%  light grey           32x31x31
  stl/original/roll_motor_top.stl               2  PLA 15%  light grey           38x29x20
  stl/original/trunk_bottom.stl                 1  PLA 15%  dark grey            108x74x54   Main frame.
  stl/original/trunk_top.stl                    1  PLA 15%  dark grey            125x101x41  Main frame.
  stl/original/neck_left_sheet.stl              1  PLA 15%  dark grey            58x31x7
  stl/original/neck_right_sheet.stl             1  PLA 15%  dark grey            58x31x6
  stl/original/head_pitch_to_yaw.stl            1  PLA 15%  dark grey            72x45x32
  stl/original/head_yaw_to_roll.stl             1  PLA 15%  dark grey            88x80x42
  stl/original/head_roll_mount.stl              1  PLA 15%  dark grey            65x40x15
  stl/original/left_eye.stl                     1  PLA 15%  any                  35x35x4     Optional: eye lights.
  stl/original/right_eye.stl                    1  PLA 15%  any                  40x40x8     Optional: eye lights.
  stl/original/bulb.stl                         1  PLA 15%  any                  35x35x2     Optional: projector.
  stl/original/flash_light_module.stl           1  PLA 15%  any                  41x31x28    Optional: projector.
  stl/original/flash_reflector_interface.stl    1  PLA 15%  any                  23x23x13    Optional: projector.
  stl/original/speaker_interface.stl            1  PLA 15%  any                  39x37x21    Optional: speaker.
  stl/original/speaker_stand.stl                1  PLA 15%  any                  51x47x46    Optional: speaker.

ROUGH FILAMENT (estimate; the slicer gives the real number)
  graphite (#2e3337)       about 540 g
  dark grey                about 360 g
  orange (#ff7a1a)         about 140 g
  dark grey (#3d444a)      about 90 g
  black TPU                about 30 g
  light grey               about 30 g
  any                      about 20 g

NOT INCLUDED
  Servos, electronics, screws, heat-set inserts and bearings.

LICENCE
  Original parts: Open Duck Mini by Antoine Pirrone and contributors, Apache License 2.0
  (see LICENSE and NOTICE).
