LucasStrand/open-duck-mini-duckling/(commit log)

2026-10-24 Add Duckling shells for Open Duck Mini v2
    Rounder duck-shaped head, body and thigh-cover shells plus a bill, made
    by reshaping the official parts in Blender with free-form deformation
    cages and a clearance check against the parts inside. Includes the
    unchanged official parts, a print list, renders and the build scripts.
    Not test-printed yet.
    [battery_pack_lid_duckling.stl, body_back_duckling.stl, body_front_duckling.stl, body_middle_bottom_duckling.stl, body_middle_top_duckling.stl, bulb.stl, duck_bill.stl, flash_light_module.stl]
2026-10-24 Add Pebble and Visor shells, colour schemes, tail; flatten head plates
    - Pebble and Visor: the two other reshaped designs, 11 parts each, with
    their own print lists.
    - Head bottom plates and head rims now stay perfectly flat (the cage's
    bottom layers no longer move vertically); the earlier Duckling plate
    was bent by about 0.26 mm.
    - Bill and tail moved to stl/addons/; README covers all three shapes,
    the six colour schemes and the add-ons.
    - Part orientations re-checked by surface distance; tools updated.
    [battery_pack_lid_duckling.stl, battery_pack_lid_pebble.stl, battery_pack_lid_visor.stl, body_back_duckling.stl, body_back_pebble.stl, body_back_visor.stl, body_front_pebble.stl, body_front_visor.stl]
